ricard2k/trainControllerElectronics/pcb_bounds.dxf

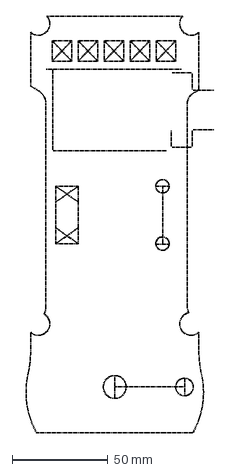
[picture p1: CAD file, 2025-05-03]
pcb_bounds.dxf
98.3 x 218.0 mm
