ricard2k/trainControllerElectronics/trainControllerElectronics.kicad_pcb

## KiCad design trainControllerElectronics.kicad_pcb (2025-05-03)

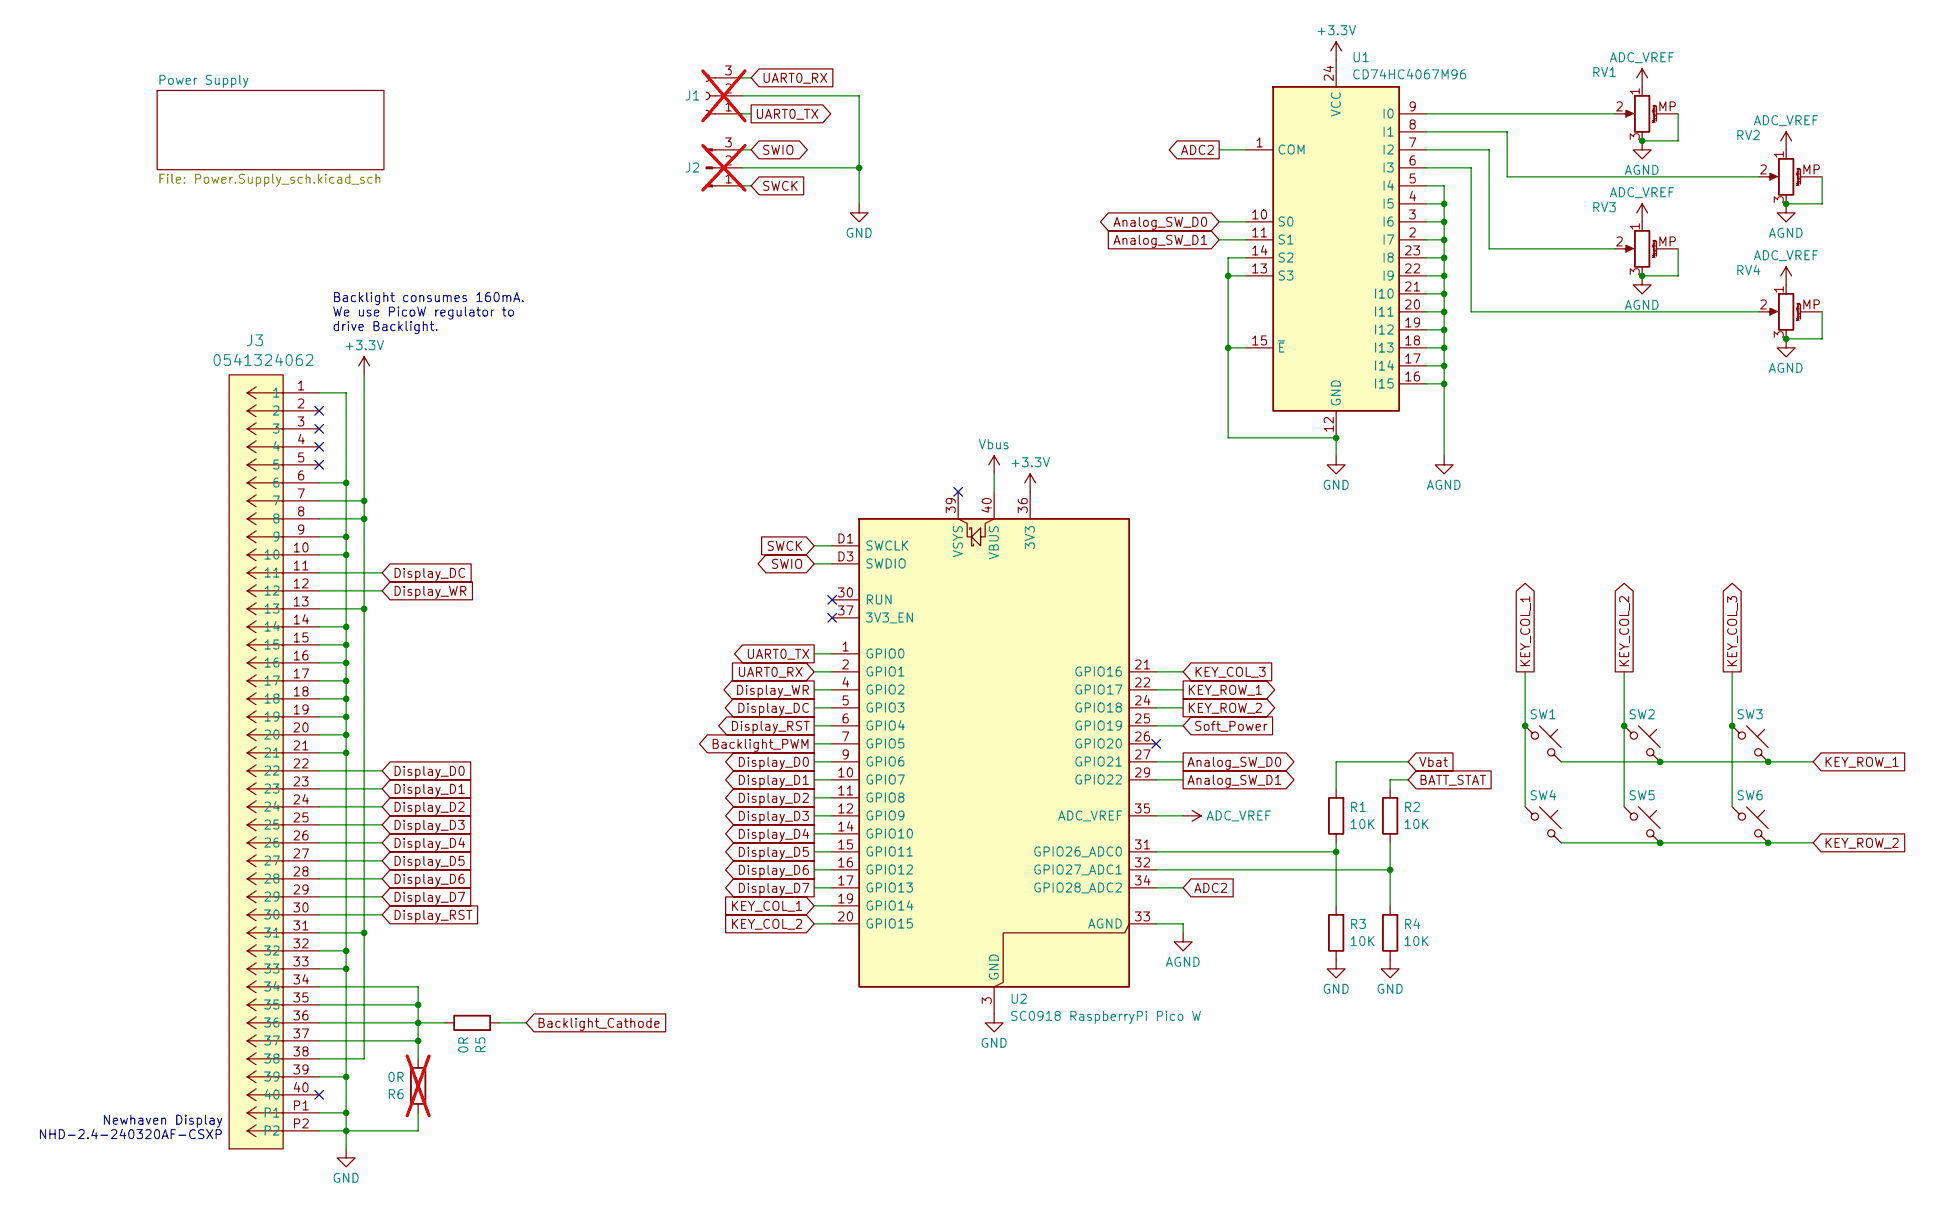
[picture p2: schematic trainControllerElectronics.kicad_sch]

Parts:
J1: Pin socket 2.54 1x03; PinSocket_1x03_P2.54mm_Horizontal; not fitted
J2: Pin header 2.54 1x03; PinHeader_1x03_P2.54mm_Horizontal; not fitted
J3: 0541324062; CON_541324062_MOL; Manufacturer part 0541324062; Digikey part ‎WM3436CT-ND‎
R1, R2, R3, R4: 10K; R_0805_2012Metric_Pad1.20x1.40mm_HandSolder
R5: 0R; R_0805_2012Metric_Pad1.20x1.40mm_HandSolder
R6: 0R; R_0805_2012Metric_Pad1.20x1.40mm_HandSolder; not fitted
RV1, RV2, RV3, RV4: PTV09A-4015F-B104‎; Potentiometer_Bourns_PTV09A-1_Single_Vertical; Manufacturer part PTV09A-4015F-B104‎; Digikey part PTV09A-4015F-B104-ND‎
SW1, SW2, SW3, SW4, SW5, SW6: 1825910-6; SW_PUSH_6mm; Manufacturer part 1825910-6; Digikey part 450-1650-ND
U1: CD74HC4067M96; SOIC-24W_7.5x15.4mm_P1.27mm; Manufacturer part CD74HC4067M96; Digikey part 296-29408-1-ND
U2: SC0918 RaspberryPi Pico W; RaspberryPi_Pico_W_SMD_HandSolder; Manufacturer part SC0918; Digikey part 2648-SC0918CT-ND

Connections:
+3.3V: J3.7, J3.8, J3.13, J3.31, J3.38, U1.24 (VCC), U2.36 (3V3)
ADC2: U1.1 (COM), U2.34 (GPIO28_ADC2)
ADC_VREF: RV1.1, RV2.1, RV3.1, RV4.1, U2.35 (ADC_VREF)
AGND: RV1.3, RV1.MP (MountPin), RV2.3, RV2.MP (MountPin), RV3.3, RV3.MP (MountPin), RV4.3, RV4.MP (MountPin), U1.2 (I7), U1.3 (I6), U1.4 (I5), U1.5 (I4), U1.16 (I15), U1.17 (I14), U1.18 (I13), U1.19 (I12), U1.20 (I11), U1.21 (I10), U1.22 (I9), U1.23 (I8), U2.33 (AGND)
Analog_SW_D0: U1.10 (S0), U2.27 (GPIO21)
Analog_SW_D1: U1.11 (S1), U2.29 (GPIO22)
BATT_STAT: R2.2; also elsewhere on the board
Backlight_Cathode: R5.2; also elsewhere on the board
Backlight_PWM: U2.7 (GPIO5); also elsewhere on the board
Display_D0: J3.22, U2.9 (GPIO6)
Display_D1: J3.23, U2.10 (GPIO7)
Display_D2: J3.24, U2.11 (GPIO8)
Display_D3: J3.25, U2.12 (GPIO9)
Display_D4: J3.26, U2.14 (GPIO10)
Display_D5: J3.27, U2.15 (GPIO11)
Display_D6: J3.28, U2.16 (GPIO12)
Display_D7: J3.29, U2.17 (GPIO13)
Display_DC: J3.11, U2.5 (GPIO3)
Display_RST: J3.30, U2.6 (GPIO4)
Display_WR: J3.12, U2.4 (GPIO2)
GND: J1.2, J2.2, J3.1, J3.6, J3.9, J3.10, J3.14, J3.15, J3.16, J3.17, J3.18, J3.19, J3.20, J3.21, J3.32, J3.33, J3.39, J3.P1, J3.P2, R3.1, R4.1, R6.2, U1.12 (GND), U1.13 (S3), U1.14 (S2), U1.15 (~E), U2.3 (GND), U2.8 (GND), U2.13 (GND), U2.18 (GND), U2.23 (GND), U2.28 (GND), U2.38 (GND), U2.D2 (GND); also elsewhere on the board
KEY_COL_1: SW1.1, SW4.1, U2.19 (GPIO14)
KEY_COL_2: SW2.1, SW5.1, U2.20 (GPIO15)
KEY_COL_3: SW3.1, SW6.1, U2.21 (GPIO16)
KEY_ROW_1: SW1.2, SW2.2, SW3.2, U2.22 (GPIO17)
KEY_ROW_2: SW4.2, SW5.2, SW6.2, U2.24 (GPIO18)
unnamed: J3.34, J3.35, J3.36, J3.37, R5.1, R6.1
unnamed: RV1.2, U1.9 (I0)
unnamed: RV2.2, U1.8 (I1)
unnamed: RV3.2, U1.7 (I2)
unnamed: RV4.2, U1.6 (I3)
unnamed: R1.1, R3.2, U2.31 (GPIO26_ADC0)
unnamed: R2.1, R4.2, U2.32 (GPIO27_ADC1)
SWCK: J2.1, U2.D1 (SWCLK)
SWIO: J2.3, U2.D3 (SWDIO)
Soft_Power: U2.25 (GPIO19); also elsewhere on the board
UART0_RX: J1.3, U2.2 (GPIO1)
UART0_TX: J1.1, U2.1 (GPIO0)
Vbat: R1.2; also elsewhere on the board
Vbus: U2.40 (VBUS); also elsewhere on the board

Notes on the sheet:
Backlight consumes 160mA. We use PicoW regulator to drive Backlight.
Newhaven Display NHD-2.4-240320AF-CSXP

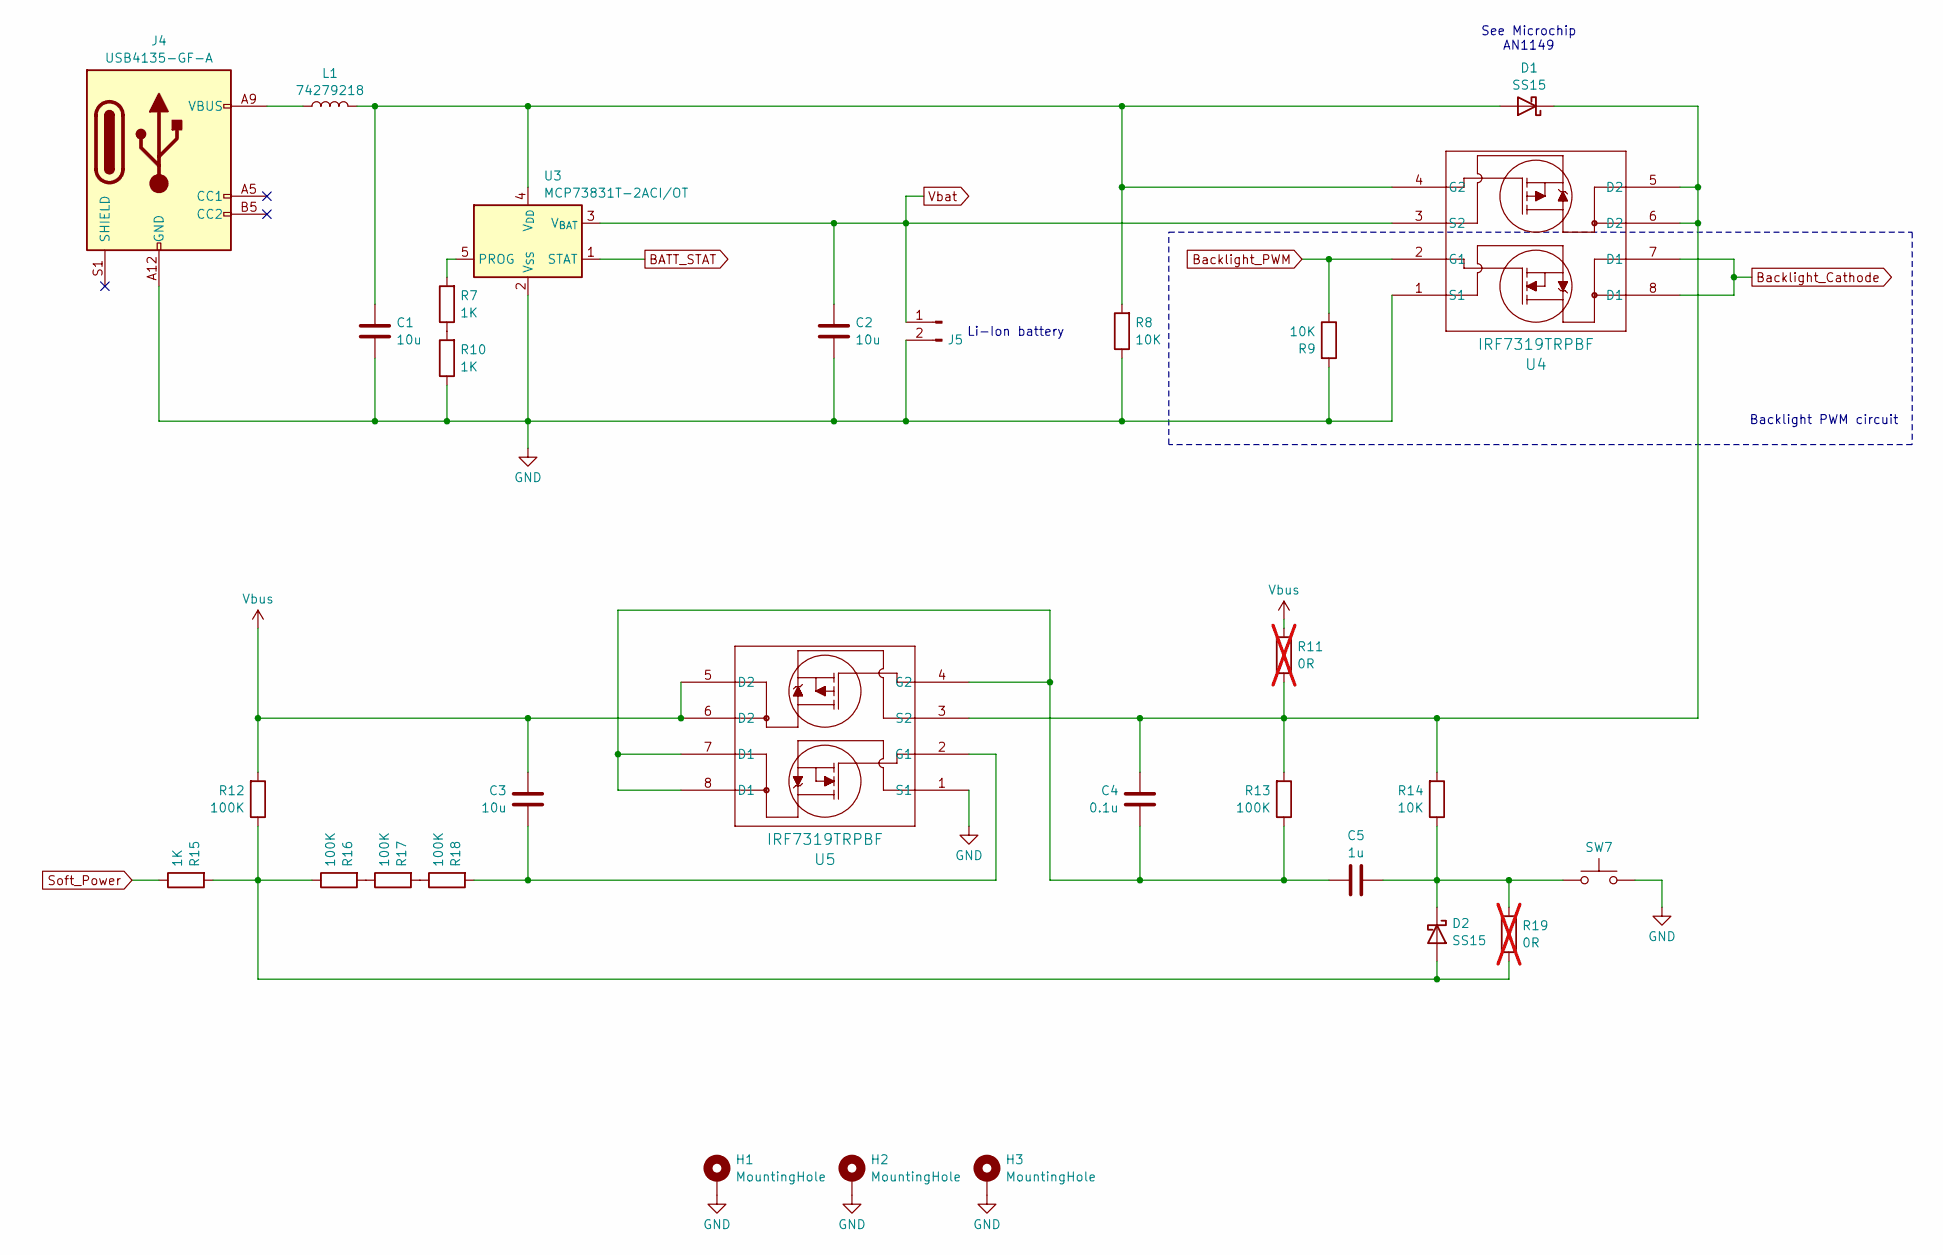
[picture p3: schematic Power.Supply_sch.kicad_sch]

Parts:
C1, C2, C3: 10u; C_0805_2012Metric_Pad1.18x1.45mm_HandSolder
C4: 0.1u; C_0805_2012Metric_Pad1.18x1.45mm_HandSolder
C5: 1u; C_0805_2012Metric_Pad1.18x1.45mm_HandSolder
D1, D2: SS15; D_SMA
H1, H2, H3: MountingHole; MountingHole_3.2mm_M3_Pad_Via
J4: USB4135-GF-A; USB_C_Receptacle_GCT_USB4135-GF-A_6P_TopMnt_Horizontal; Manufacturer part USB4135-GF-A; Digikey part 2073-USB4135-GF-ACT-ND
J5: B2B-PH-K-S; JST_PH_B2B-PH-K_1x02_P2.00mm_Vertical; manufacturer part B2B-PH-K-S; Digikey part 455-1704-ND
L1: 74279218; L_1206_3216Metric_Pad1.42x1.75mm_HandSolder
R7, R10, R15: 1K; R_0805_2012Metric_Pad1.20x1.40mm_HandSolder
R8, R9, R14: 10K; R_0805_2012Metric_Pad1.20x1.40mm_HandSolder
R11, R19: 0R; R_0805_2012Metric_Pad1.20x1.40mm_HandSolder; not fitted
R12, R13, R16, R17, R18: 100K; R_0805_2012Metric_Pad1.20x1.40mm_HandSolder
SW7: 1825910-6; SW_PUSH_6mm; Manufacturer part 1825910-6; Digikey part 450-1650-ND
U3: MCP73831T-2ACI/OT; SOT-23-5; Manufacturer part MCP73831T-2ACI/OT; Digikey part MCP73831T-2ACI/OTCT-ND
U4, U5: IRF7319TRPBF; TRANS_IRF7103TRPBF_INF

Connections:
BATT_STAT: U3.1 (STAT); also elsewhere on the board
Backlight_Cathode: U4.7 (D1), U4.8 (D1); also elsewhere on the board
Backlight_PWM: R9.1, U4.2 (G1); also elsewhere on the board
GND: C1.2, C2.2, H1.1, H2.1, H3.1, J4.A12 (GND), J4.B12 (GND), J5.2, R8.1, R9.2, R10.1, SW7.2, U3.2 (V_{SS}), U4.1 (S1), U5.1 (S1); also elsewhere on the board
unnamed: C1.1, D1.2 (A), L1.2, R8.2, U3.4 (V_{DD}), U4.4 (G2)
unnamed: C4.2, D1.1 (K), R11.1, R13.2, R14.2, U4.5 (D2), U4.6 (D2), U5.3 (S2)
unnamed: D2.2 (A), R12.1, R15.2, R16.1, R19.1
unnamed: C5.1, D2.1 (K), R14.1, R19.2, SW7.1
unnamed: J4.A9 (VBUS), J4.B9 (VBUS), L1.1
unnamed: R7.1, R10.2
unnamed: R16.2, R17.1
unnamed: R17.2, R18.1
unnamed: R7.2, U3.5 (PROG)
unnamed: C3.1, R18.2, U5.2 (G1)
unnamed: C4.1, C5.2, R13.1, U5.4 (G2), U5.7 (D1), U5.8 (D1)
Soft_Power: R15.1; also elsewhere on the board
Vbat: C2.1, J5.1, U3.3 (V_{BAT}), U4.3 (S2); also elsewhere on the board
Vbus: C3.2, R11.2, R12.2, U5.5 (D2), U5.6 (D2); also elsewhere on the board

Notes on the sheet:
Li-Ion battery
Backlight PWM circuit
See Microchip AN1149

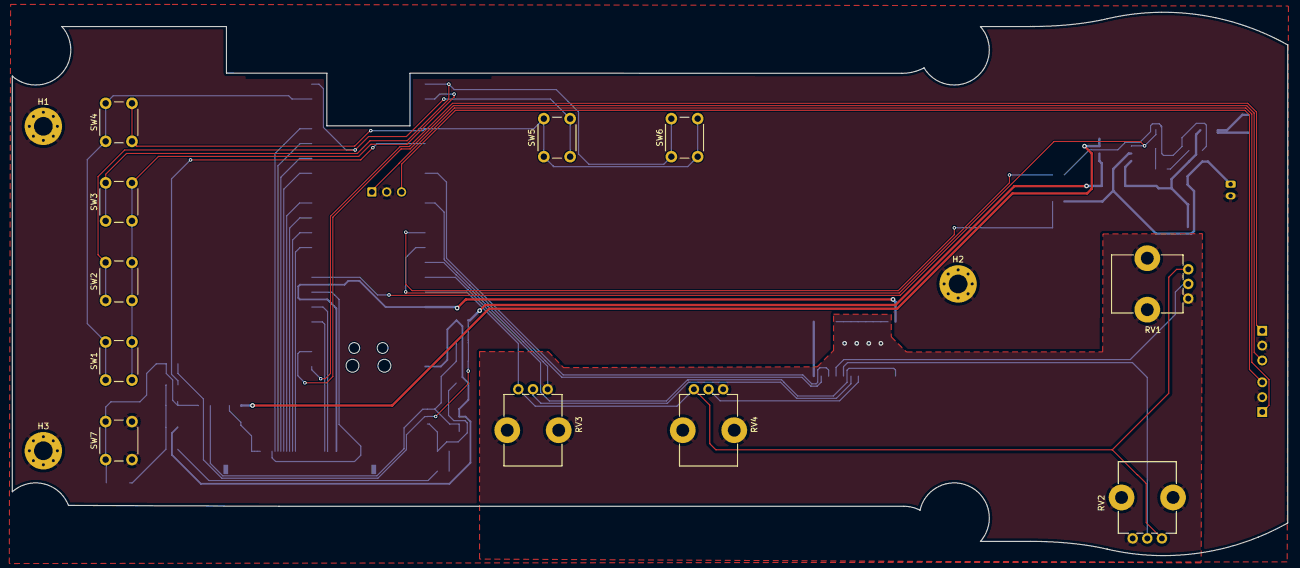
[picture p4: board trainControllerElectronics.kicad_pcb from above]

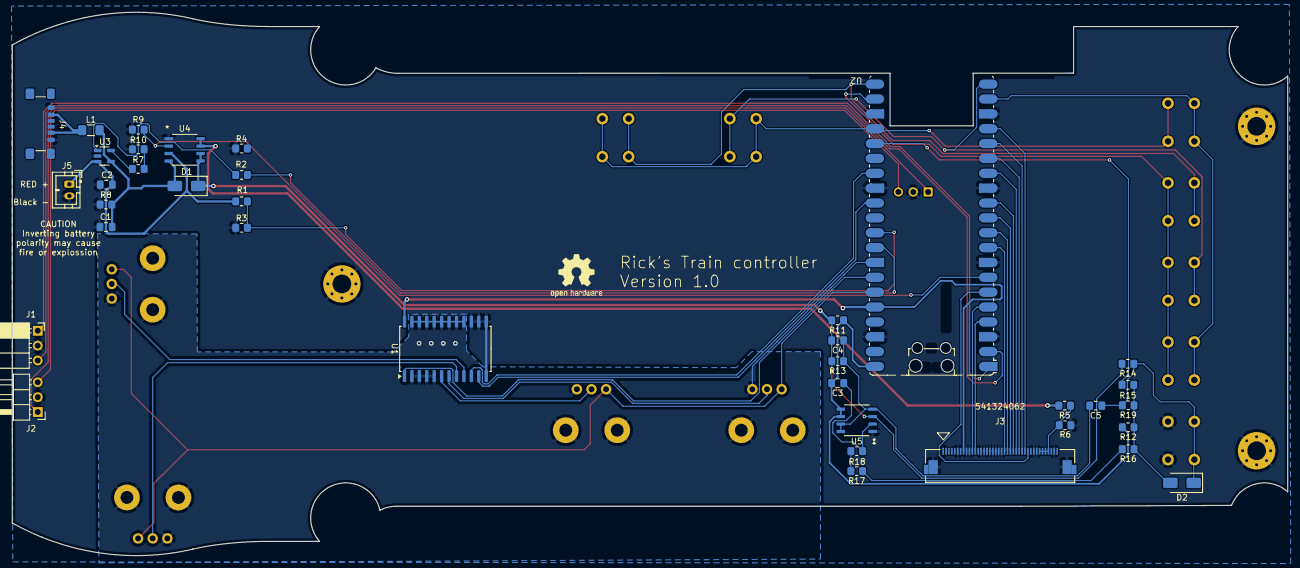
[picture p5: board trainControllerElectronics.kicad_pcb from below]

Board: 2 copper layers, 218.0 x 92.9 mm, 51 parts (37 on the bottom side), 51 nets.
