ricard2k/trainControllerElectronics/(commit log)

2025-04-15 library cleaned
    [trainControllerElectronics.kicad_pcb, trainControllerElectronics.kicad_sch]
2025-04-15 New mosfet
    [trainControllerElectronics.kicad_pcb, trainControllerElectronics.kicad_sch]
2025-04-15 Added Battery meter
    [trainControllerElectronics.kicad_pcb, trainControllerElectronics.kicad_sch]
2025-05-03 PCB ready
    [Power.Supply_sch.kicad_sch, pcb_bounds.dxf, trainControllerElectronics.kicad_pcb, trainControllerElectronics.kicad_sch]
